rivargut/aire-nuevo/Box/BOX_F5.SLDPRT

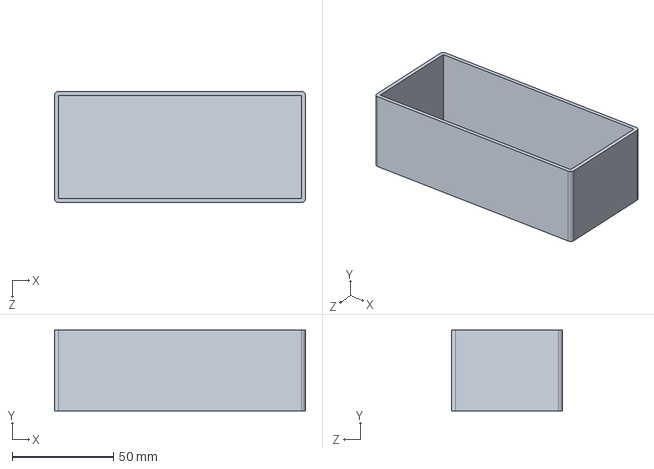
[picture p1: CAD file, 2020-01-30]
Box/BOX_F5.SLDPRT
124.0 x 40.0 x 55.0 mm
