rivargut/aire-nuevo/(list of files, cad)

Other CAD files:
Box/Box F5.SLDPRT
Box/Box F5.STL
