rivargut/aire-nuevo/ECUGPSrev2/ECU GPS Schematic.pdf

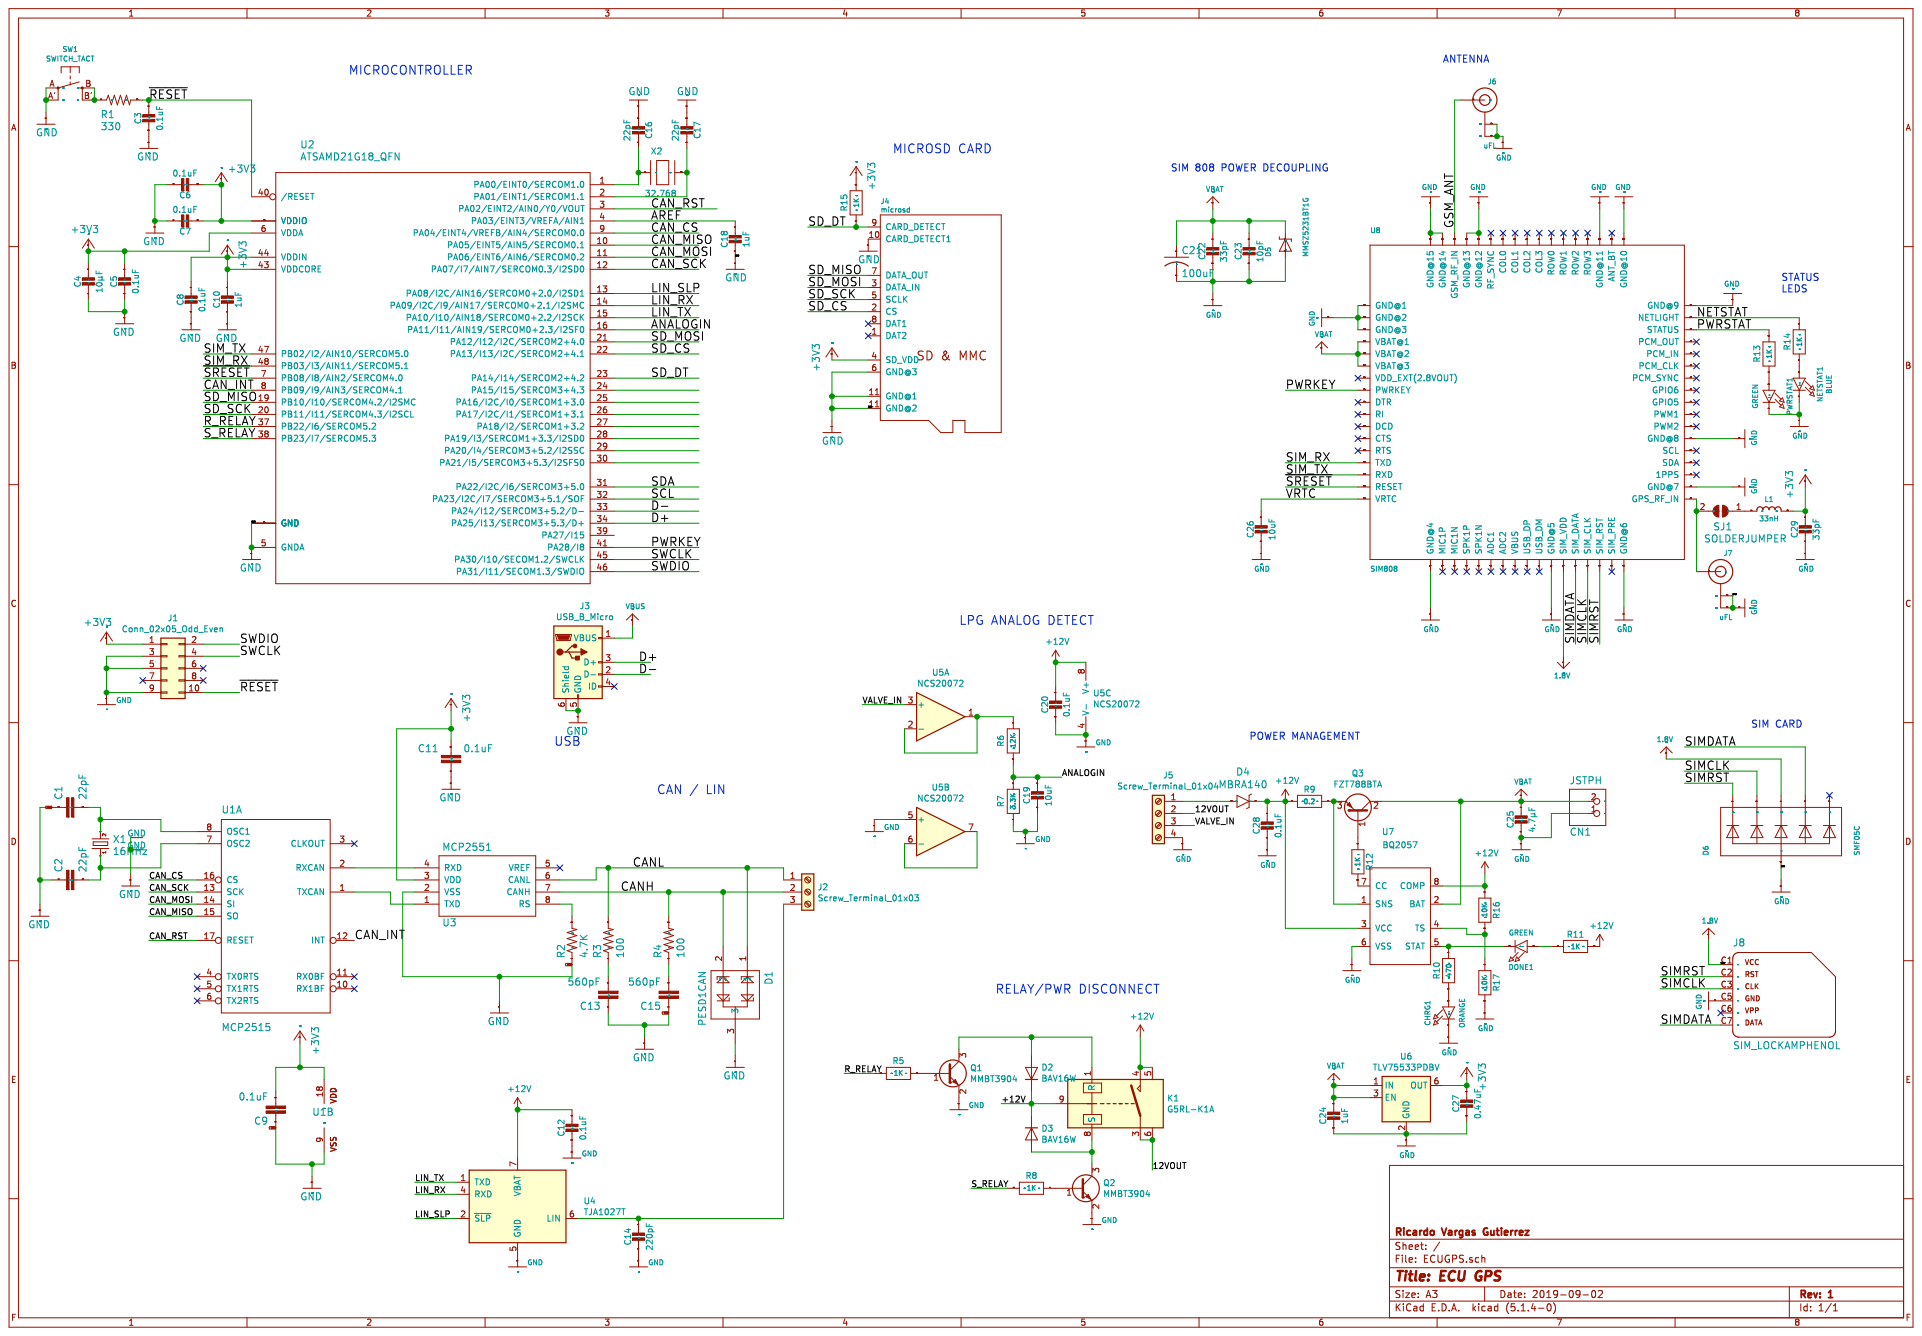
[picture p2: page 1]
