rivargut/aire-nuevo/ECUGPSrev2/ECUGPS.kicad_pcb

## KiCad design ECUGPSrev2/ECUGPS.kicad_pcb (2020-06-15)

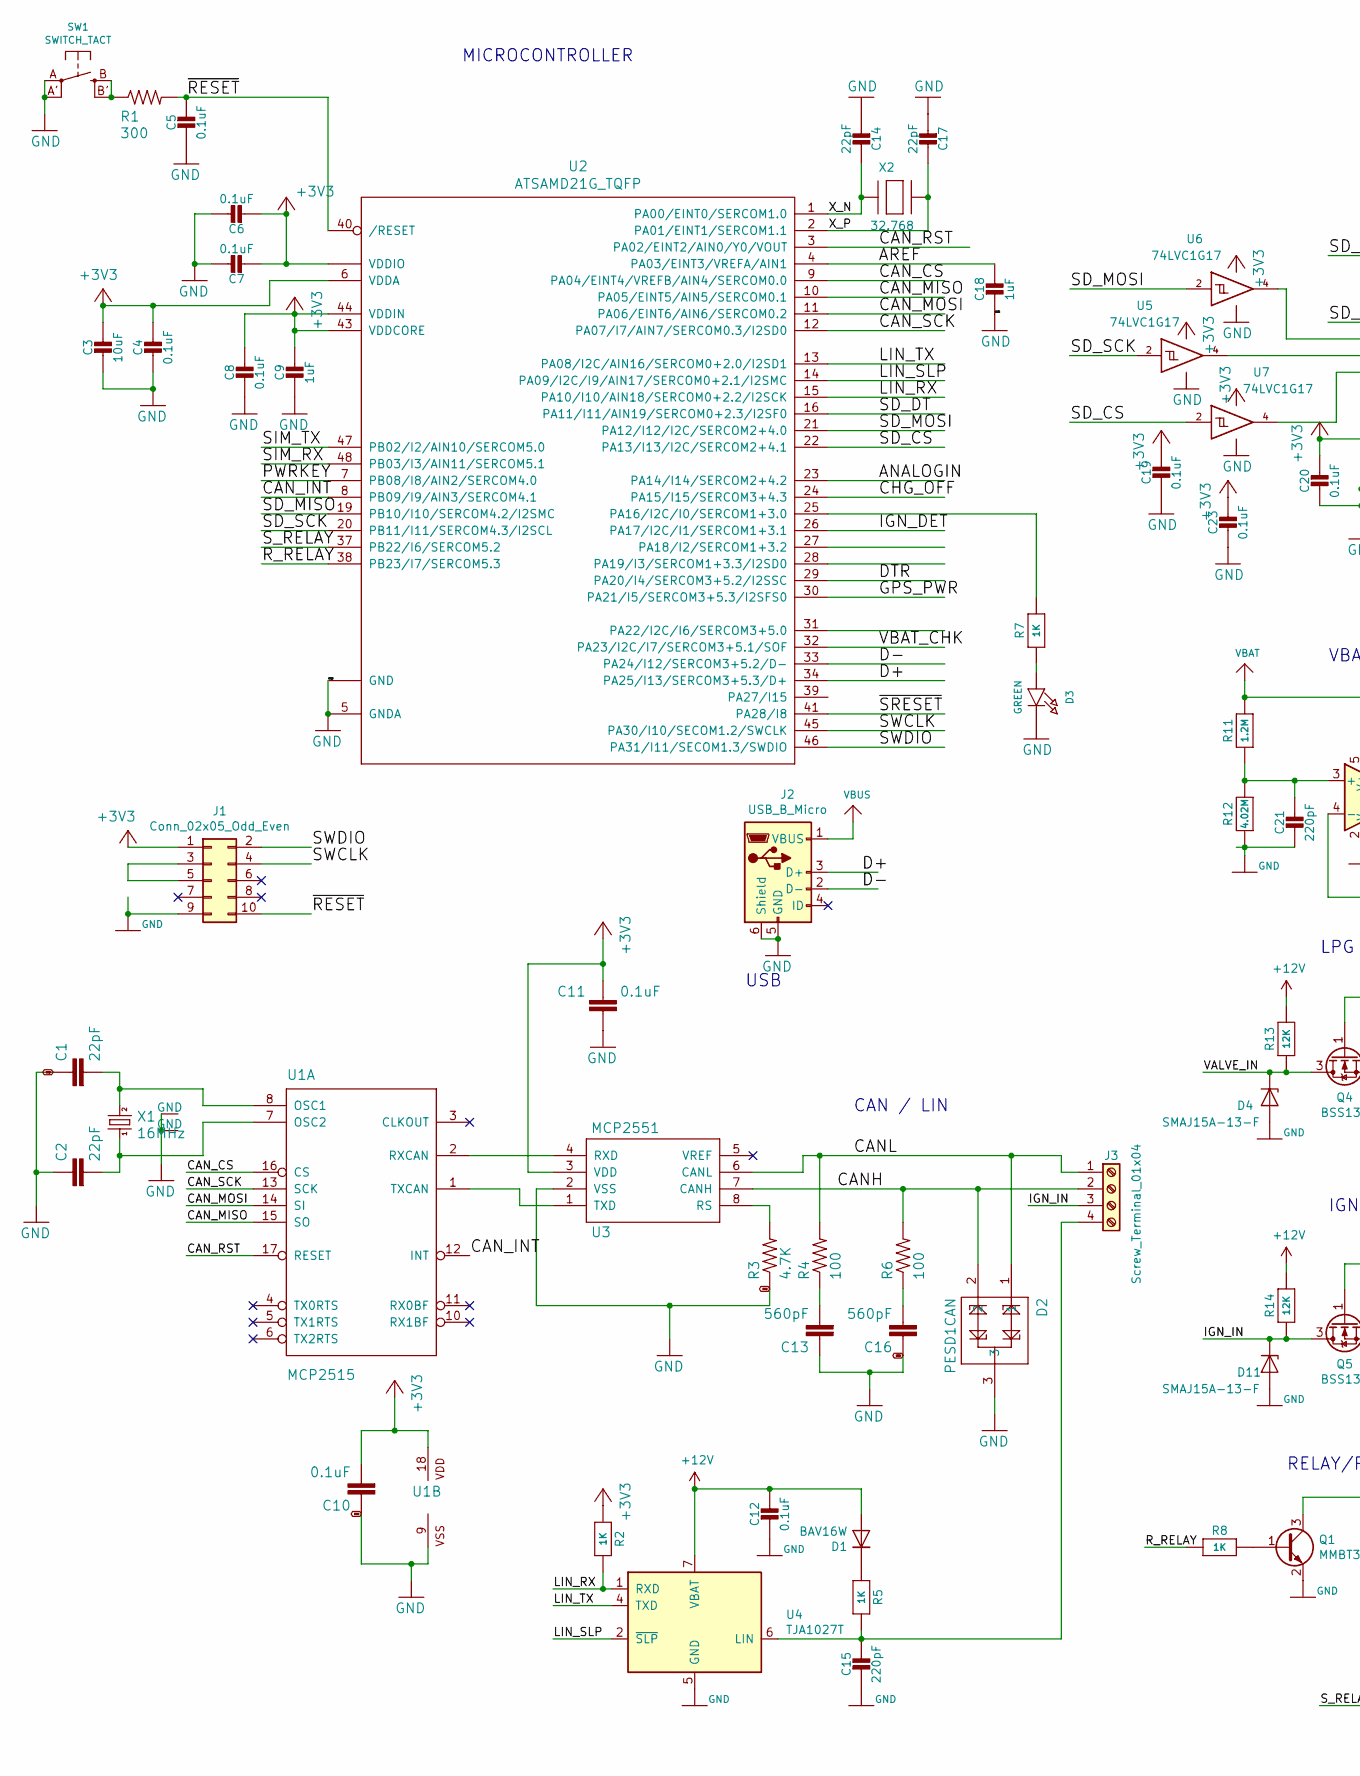
[picture p3: schematic ECUGPS.sch, ECU GPS, part in row 1, column 1]

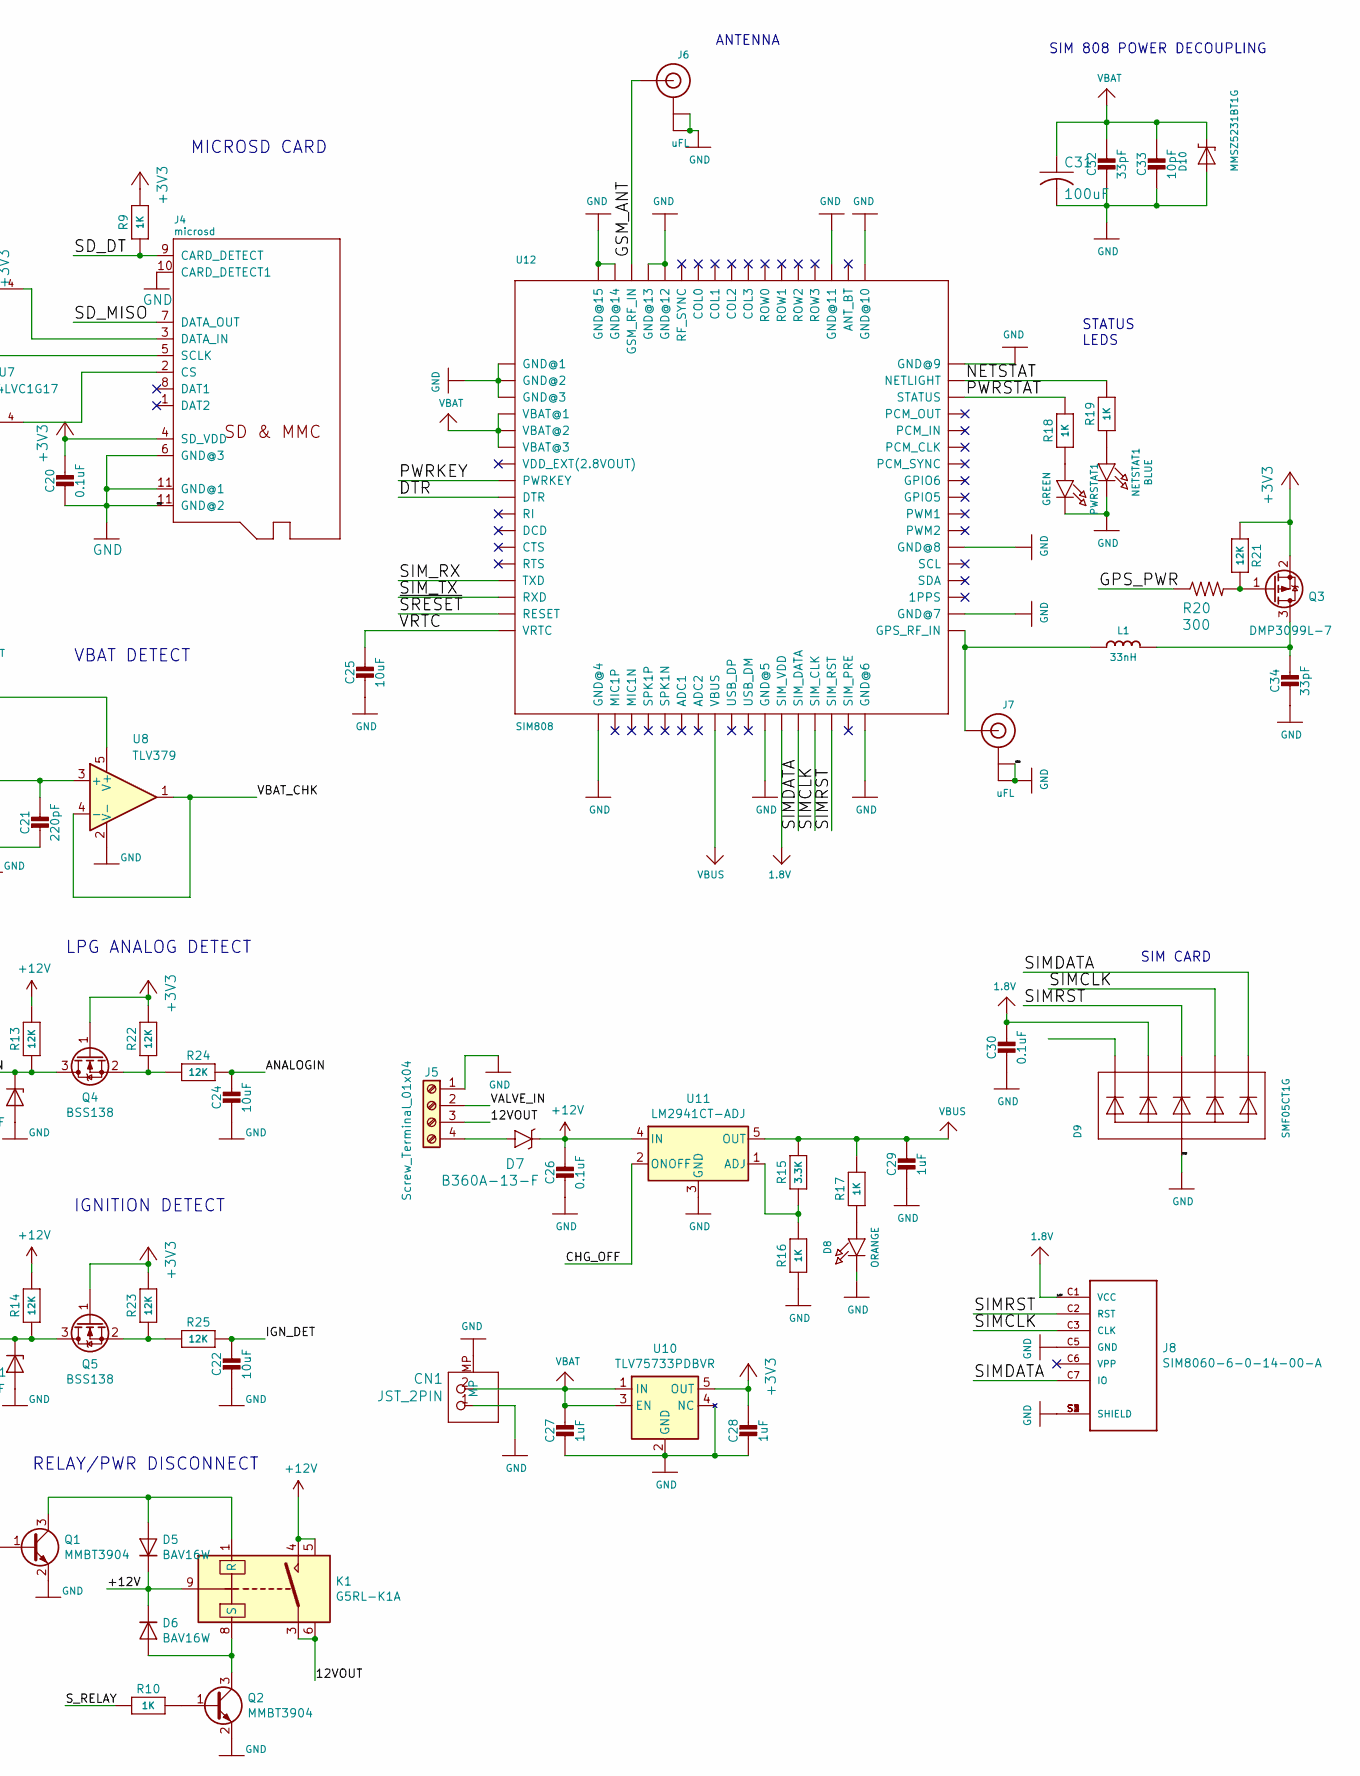
[picture p4: schematic ECUGPS.sch, ECU GPS, part in row 1, column 2]

Parts:
C1, C2, C14, C17: 22pF; C_0603_1608Metric; Part CC0603JRNPO9BN220
C3, C22, C24, C25: 10uF; C_0603_1608Metric; Part 0603ZD106KAT2A
C4, C5, C6, C7, C8, C10, C11, C12, C19, C20, C23, C26, C30: 0.1uF; C_0603_1608Metric; Part CL10B104KB8NNNL
C9, C18, C27, C28, C29: 1uF; C_0603_1608Metric; Part CL10A105KP8NNNC
C13, C16: 560pF; C_0603_1608Metric; Part CL10B561KB8NNNC
C15, C21: 220pF; C_0603_1608Metric; Part CL10B221KB8NNNC
C31: 100uF; C_1206_3216Metric; Part CL31A107MQHNNNE
C32, C34: 33pF; C_0603_1608Metric; Part CL10C330JB8NNNC
C33: 10pF; C_0603_1608Metric; Part CL10C100JB8NNNC
CN1: JST_2PIN; JST_PH_S2B-PH-SM4-TB_1x02-1MP_P2.00mm_Horizontal
D1, D5, D6: BAV16W; D_SOD-123; Part BAV16W-7-F
D2: PESD1CAN; SOT-23; Part PESD1CAN-UX
D3: GREEN; LED_0805_2012Metric; Part 150080VS75000
D4, D11: SMAJ15A-13-F; D_SMA
D7: B360A-13-F‎; D_SMA; Part B360A-13-F‎
D8: ORANGE; LED_0805_2012Metric; Part LTST-C170KFKT
D9: SMF05CT1G; SOT-363_SC-70-6; Part SMF05CT1G
D10: MMSZ5231BT1G; D_SOD-123; Part MSZ5231BT1G
J1: Conn_02x05_Odd_Even; PinHeader_2x5_P1.27mm; Part 20021121-00010C4LF
J2: USB_B_Micro; GCT_USB3145-XX-X_REVB; Part 1050170001
J3, J5: Screw_Terminal_01x04; TerminalBlock_Phoenix_MPT-0,5-4-2.54_1x04_P2.54mm_Horizontal; Part OSTVN04A150
J4: microsd; Hirose_DM3D-SF; Part M3D-SF(41)
J6, J7: uFL; U.FL_Molex_MCRF_73412-0110_Vertical; Part 0734120110
J8: SIM8060-6-0-14-00-A; GCT_SIM8060-6-0-14-00-A
K1: G5RL-K1A; Relay_SPST_Omron_G5RL; Part G5RL-K1A-E-DC12
L1: 33nH; L_0805; Part CE201210-33NJ
NETSTAT1: BLUE; LED_0805_2012Metric; Part 150080BS75000
PWRSTAT1: GREEN; LED_0805_2012Metric; Part 150080VS75000
Q1, Q2: MMBT3904; SOT-23; Part MMBT3904
Q3: DMP3099L-7; SOT-23
Q4, Q5: BSS138; SOT-23
R1, R20: 300; R_0805_2012Metric; Part ERJ-6GEYJ301V
R2, R5, R7, R8, R9, R10, R16, R17, R18, R19: 1K; R_0805_2012Metric; Part ERJ-6ENF1001V
R3: 4.7K; R_0805_2012Metric; Part ERJ-6ENF4701V
R4, R6: 100; R_0805_2012Metric; Part ERJ-6ENF1000V
R11: 1.2M; R_0805_2012Metric; Part ERJ-6ENF1204V
R12: 4.02M; R_0805_2012Metric; Part RC0805FR-074M02L
R13, R14, R21, R22, R23, R24, R25: 12K; R_0805_2012Metric; Part ERJ-6ENF1202V
R15: 3.3K; R_0805_2012Metric; Part ERJ-6ENF3301V
SW1: SWITCH_TACT; EVQ-Q2; Part EVQ-Q2B03W
U1: MCP2515; SOIC-18W_7.5x11.6mm_Pitch1.27mm; Part MCP2515T-I/SO
U2: ATSAMD21G_TQFP; TQFP-48_7x7mm_P0.5mm
U3: MCP2551; SOIC-8_3.9x4.9mm_P1.27mm; Part MCP2551T-I/SN
U4: TJA1027T; SOIC-8_3.9x4.9mm_P1.27mm; Part TJA1027T/20
U5, U6, U7: 74LVC1G17; SOT-23-5
U8: TLV379; TSOP-5_1.65x3.05mm_P0.95mm
U10: TLV75733PDBVR; SOT-23-5; Part TLV75733PDBVR
U11: LM2941CT-ADJ; TO-220-5_Vertical
U12: SIM808; SIM900_SMT; Part SIM808
X1: 16MHz; Crystal_SMD_Abracon_ABM3B-4Pin_5.0x3.2mm; Part ABM3B-16.000MHZ-B2-T
X2: 32.768; Crystal_SMD_G8-2pin_3.2x1.5mm; Part FC-135 32.7680KA-A5

Connections:
1.8V: C30.1, D9.3 (C2), J8.C1 (VCC), U12.P$29 (SIM_VDD)
+3V3: C3.1, C4.1, C6.2, C7.2, C8.1, C9.1, C10.2, C11.2, C19.1, C20.1, C23.1, C28.1, J1.1, J4.4 (SD_VDD), Q3.2 (S), Q4.1 (G), Q5.1 (G), R2.2, R9.2, R21.2, R22.1, R23.1, U1.18 (VDD), U2.6 (VDDA), U2.17 (VDDIO), U2.36 (VDDIO), U2.43 (VDDCORE), U2.44 (VDDIN), U3.3 (VDD), U5.5 (VCC), U6.5 (VCC), U7.5 (VCC), U10.5 (OUT)
+12V: C12.1, C26.1, D1.2 (A), D5.1 (K), D6.1 (K), D7.1, K1.4, K1.5, K1.9, R13.1, R14.1, U4.7 (VBAT), U11.4 (IN)
/12VOUT: J5.3, K1.3, K1.6
/ANALOGIN: C24.1, R24.1, U2.23 (PA14/I14/SERCOM2+4.2)
/AREF: C18.1, U2.4 (PA03/EINT3/VREFA/AIN1)
/CANH: D2.2, J3.2, R6.2, U3.7 (CANH)
/CANL: D2.1, J3.1, R4.2, U3.6 (CANL)
/CAN_CS: U1.16 (CS), U2.9 (PA04/EINT4/VREFB/AIN4/SERCOM0.0)
/CAN_INT: U1.12 (INT), U2.8 (PB09/I9/AIN3/SERCOM4.1)
/CAN_MISO: U1.15 (SO), U2.10 (PA05/EINT5/AIN5/SERCOM0.1)
/CAN_MOSI: U1.14 (SI), U2.11 (PA06/EINT6/AIN6/SERCOM0.2)
/CAN_RST: U1.17 (RESET), U2.3 (PA02/EINT2/AIN0/Y0/VOUT)
/CAN_SCK: U1.13 (SCK), U2.12 (PA07/I7/AIN7/SERCOM0.3/I2SD0)
/CHG_OFF: U2.24 (PA15/I15/SERCOM3+4.3), U11.2 (ONOFF)
/D+: J2.3 (D+), U2.34 (PA25/I13/SERCOM3+5.3/D+)
/D-: J2.2 (D-), U2.33 (PA24/I12/SERCOM3+5.2/D-)
/DTR: U2.29 (PA20/I4/SERCOM3+5.2/I2SSC), U12.P$9 (DTR)
/GPS_PWR: R20.1, U2.30 (PA21/I5/SERCOM3+5.3/I2SFS0)
/GSM_ANT: J6.1 (SIGNAL), U12.P$66 (GSM_RF_IN)
/IGN_DET: C22.1, R25.1, U2.26 (PA17/I2C/I1/SERCOM1+3.1)
/IGN_IN: D11.1 (K), J3.3, Q5.3 (D), R14.2
/LIN_RX: R2.1, U2.15 (PA10/I10/AIN18/SERCOM0+2.2/I2SCK), U4.1 (RXD)
/LIN_SLP: U2.14 (PA09/I2C/I9/AIN17/SERCOM0+2.1/I2SMC), U4.2 (~SLP~)
/LIN_TX: U2.13 (PA08/I2C/AIN16/SERCOM0+2.0/I2SD1), U4.4 (TXD)
/NETSTAT: R19.2, U12.P$50 (NETLIGHT)
/PWRKEY: U2.7 (PB08/I8/AIN2/SERCOM4.0), U12.P$8 (PWRKEY)
/PWRSTAT: R18.2, U12.P$49 (STATUS)
/R_RELAY: R8.2, U2.38 (PB23/I7/SERCOM5.3)
/SD_CS: U2.22 (PA13/I13/I2C/SERCOM2+4.1), U7.2
/SD_DT: J4.9 (CARD_DETECT), R9.1, U2.16 (PA11/I11/AIN19/SERCOM0+2.3/I2SF0)
/SD_MISO: J4.7 (DATA_OUT), U2.19 (PB10/I10/SERCOM4.2/I2SMC)
/SD_MOSI: U2.21 (PA12/I12/I2C/SERCOM2+4.0), U6.2
/SD_SCK: U2.20 (PB11/I11/SERCOM4.3/I2SCL), U5.2
/SIMCLK: D9.5 (C4), J8.C3 (CLK), U12.P$31 (SIM_CLK)
/SIMDATA: D9.6 (C5), J8.C7 (IO), U12.P$30 (SIM_DATA)
/SIMRST: D9.4 (C3), J8.C2 (RST), U12.P$32 (SIM_RST)
/SIM_RX: U2.48 (PB03/I3/AIN11/SERCOM5.1), U12.P$14 (TXD)
/SIM_TX: U2.47 (PB02/I2/AIN10/SERCOM5.0), U12.P$15 (RXD)
/SWCLK: J1.4, U2.45 (PA30/I10/SECOM1.2/SWCLK)
/SWDIO: J1.2, U2.46 (PA31/I11/SECOM1.3/SWDIO)
/S_RELAY: R10.2, U2.37 (PB22/I6/SERCOM5.2)
/VALVE_IN: D4.1 (K), J5.2, Q4.3 (D), R13.2
/VBAT_CHK: U2.32 (PA23/I2C/I7/SERCOM3+5.1/SOF), U8.1, U8.4 (-)
/VRTC: C25.1, U12.P$17 (VRTC)
/X_N: C14.1, U2.1 (PA00/EINT0/SERCOM1.0), X2.1
/X_P: C17.1, U2.2 (PA01/EINT1/SERCOM1.1), X2.2
/~RESET: C5.1, J1.10, R1.2, U2.40 (/RESET)
/~SRESET: U2.41 (PA28/I8), U12.P$16 (RESET)
GND: C1.1, C2.1, C3.2, C4.2, C5.2, C6.1, C7.1, C8.2, C9.2, C10.1, C11.1, C12.2, C13.1, C14.2, C15.2, C16.1, C17.2, C18.2, C19.2, C20.2, C21.2, C22.2, C23.2, C24.2, C25.2, C26.2, C27.2, C28.2, C29.2, C30.2, C31.2, C32.2, C33.2, C34.2, CN1.1, CN1.MP, D2.3, D3.1 (C), D4.2 (A), D8.1 (C), D9.2 (A), D10.2, D11.2 (A), J1.9, J2.5 (GND), J2.6 (Shield), J4.6 (GND@3), J4.10 (CARD_DETECT1), J4.11 (GND@1), J5.1, J6.2 (GND@0), J7.2 (GND@0), J8.C5 (GND), J8.S1 (SHIELD), J8.S2 (SHIELD), J8.S3 (SHIELD), J8.S4 (SHIELD), NETSTAT1.1 (C), PWRSTAT1.1 (C), Q1.2 (E), Q2.2 (E), R3.1, R12.2, R16.1, SW1.A, SW1.A' (P1), U1.9 (VSS), U2.5 (GNDA), U2.18 (GND), U2.35 (GND), U2.42 (GND), U3.2 (VSS), U4.5 (GND), U5.3 (GND), U6.3 (GND), U7.3 (GND), U8.2 (V-), U10.2 (GND), U10.4 (NC), U11.3 (GND), U12.P$1 (GND@1), U12.P$2 (GND@2), U12.P$3 (GND@3), U12.P$18 (GND@4), U12.P$28 (GND@5), U12.P$34 (GND@6), U12.P$36 (GND@7), U12.P$40 (GND@8), U12.P$51 (GND@9), U12.P$52 (GND@10), U12.P$54 (GND@11), U12.P$64 (GND@12), U12.P$65 (GND@13), U12.P$67 (GND@14), U12.P$68 (GND@15), X1.2 (GND), X1.4 (GND)
unnamed: C1.2, U1.8 (OSC1), X1.3 (2)
unnamed: C2.2, U1.7 (OSC2), X1.1
unnamed: C13.2, R4.1
unnamed: C15.1, J3.4, R5.1, U4.6 (LIN)
unnamed: C16.2, R6.1
unnamed: C21.1, R11.2, R12.1, U8.3 (+)
unnamed: C34.1, L1.2, Q3.3 (D)
unnamed: D1.1 (K), R5.2
unnamed: D3.2 (A), R7.1
unnamed: D5.2 (A), K1.1 (R), Q1.3 (C)
unnamed: D6.2 (A), K1.8 (S), Q2.3 (C)
unnamed: D7.2, J5.4
unnamed: D8.2 (A), R17.1
unnamed: J1.3, J1.5
unnamed: J4.2 (CS), U7.4
unnamed: J4.3 (DATA_IN), U6.4
unnamed: J4.5 (SCLK), U5.4
unnamed: J7.1 (SIGNAL), L1.1, U12.P$35 (GPS_RF_IN)
unnamed: NETSTAT1.2 (A), R19.1
unnamed: PWRSTAT1.2 (A), R18.1
unnamed: Q1.1 (B), R8.1
unnamed: Q2.1 (B), R10.1
unnamed: Q3.1 (G), R20.2, R21.1
unnamed: Q4.2 (S), R22.2, R24.2
unnamed: Q5.2 (S), R23.2, R25.2
unnamed: R1.1, SW1.B (S), SW1.B' (S1)
unnamed: R3.2, U3.8 (RS)
unnamed: R7.2, U2.25 (PA16/I2C/I0/SERCOM1+3.0)
unnamed: R15.2, R16.2, U11.1 (ADJ)
unnamed: U1.1 (TXCAN), U3.1 (TXD)
unnamed: U1.2 (RXCAN), U3.4 (RXD)
VBAT: C27.1, C31.1, C32.1, C33.1, CN1.2, D10.1, R11.1, U8.5 (V+), U10.1 (IN), U10.3 (EN), U12.P$4 (VBAT@1), U12.P$5 (VBAT@2), U12.P$6 (VBAT@3)
VBUS: C29.1, J2.1 (VBUS), R15.1, R17.2, U11.5 (OUT), U12.P$25 (VBUS)

Notes on the sheet:
ANTENNA
SIM 808 POWER DECOUPLING
SIM CARD
STATUS LEDS
MICROCONTROLLER
MICROSD CARD
USB
CAN / LIN
LPG ANALOG DETECT
RELAY/PWR DISCONNECT
VBAT DETECT
IGNITION DETECT

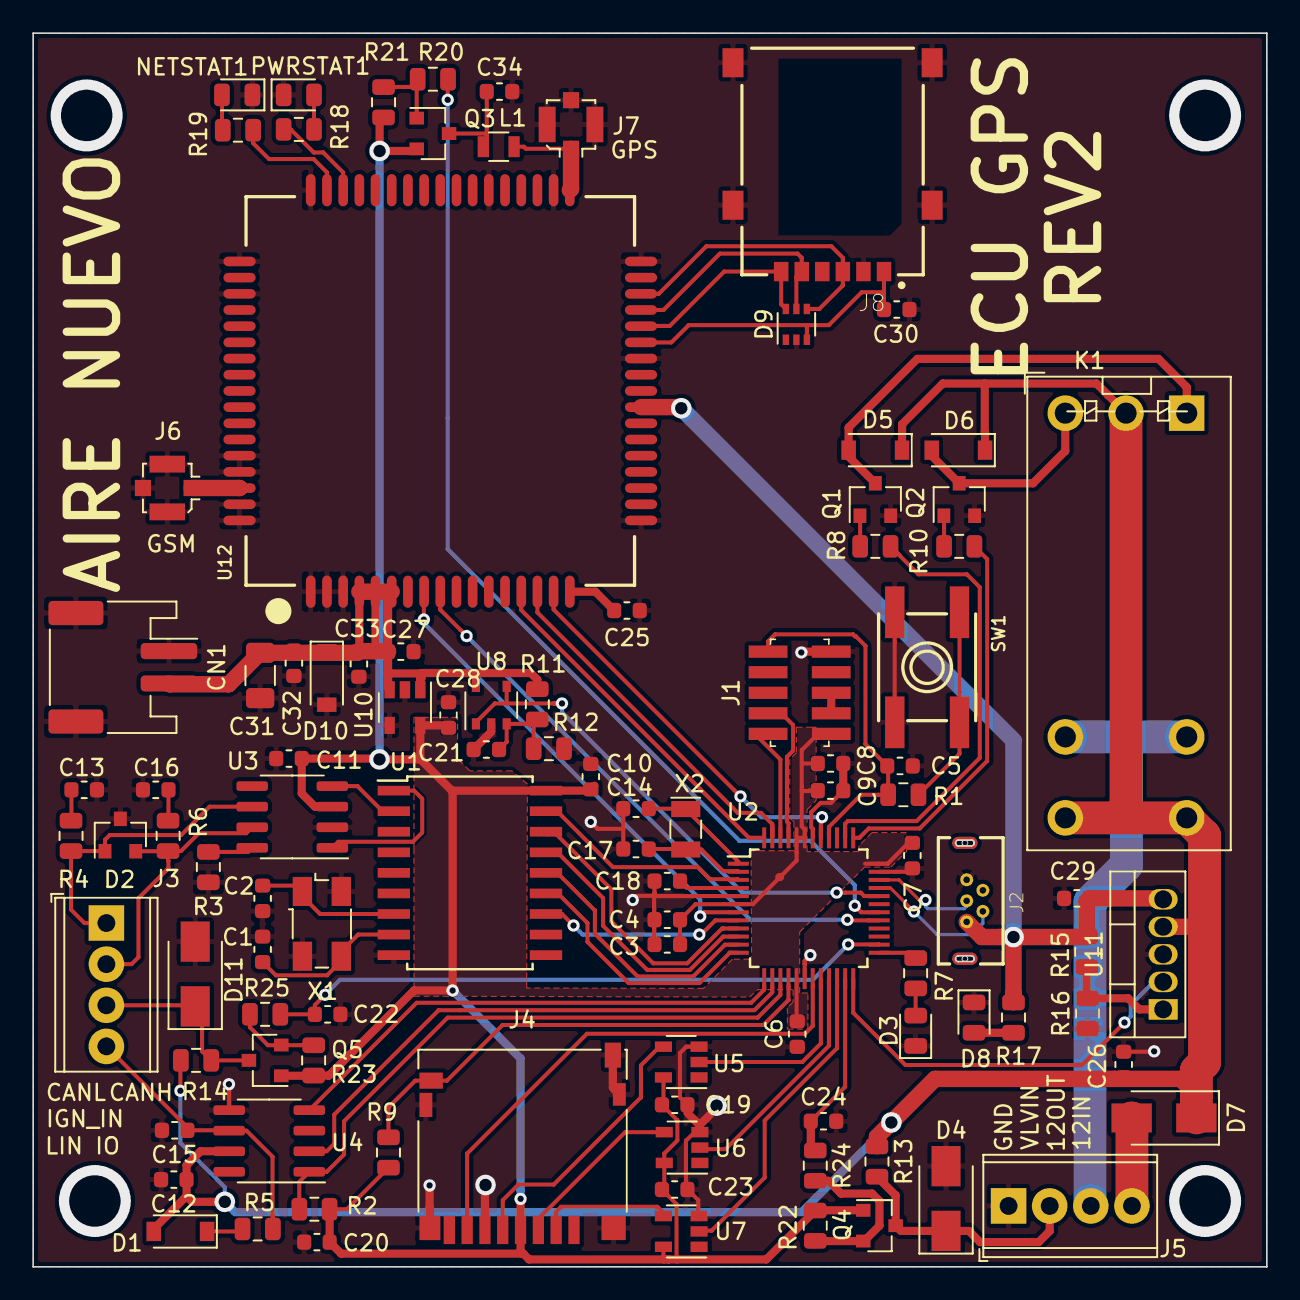
[picture p5: board ECUGPS.kicad_pcb from above]

Board: 2 copper layers, 76.2 x 76.2 mm, 102 parts (0 on the bottom side), 83 nets.
