rivargut/aire-nuevo/ECUGPS_sleep_r2/ecugps_r2/variant.h

/*
  Copyright (c) 2014-2015 Arduino LLC.  All right reserved.

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
  You should have received a copy of the GNU Lesser General Public
  License along with this library; if not, write to the Free Software
  Foundation, Inc., 51 Franklin St, Fifth Floor, Boston, MA  02110-1301  USA
*/

#ifndef _VARIANT_ARDUINO_ZERO_
#define _VARIANT_ARDUINO_ZERO_

// The definitions here needs a SAMD core >=1.6.10
#define ARDUINO_SAMD_VARIANT_COMPLIANCE 10610

/*----------------------------------------------------------------------------
 *        Definitions
 *----------------------------------------------------------------------------*/

/** Frequency of the board main oscillator */
#define VARIANT_MAINOSC		(32768ul)

/** Master clock frequency */
#define VARIANT_MCK			  (48000000ul)

/*----------------------------------------------------------------------------
 *        Headers
 *----------------------------------------------------------------------------*/

#include "WVariant.h"

#ifdef __cplusplus
#include "SERCOM.h"
#include "Uart.h"
#endif // __cplusplus

#ifdef __cplusplus
extern "C"
{
#endif // __cplusplus

/*----------------------------------------------------------------------------
 *        Pins
 *----------------------------------------------------------------------------*/

// Number of pins defined in PinDescription array
#ifdef __cplusplus
extern "C" unsigned int PINCOUNT_fn();
#endif
#define PINS_COUNT           (PINCOUNT_fn())
#define NUM_DIGITAL_PINS     (20u)
#define NUM_ANALOG_INPUTS    (1u)
#define NUM_ANALOG_OUTPUTS   (1u)
#define analogInputToDigitalPin(p)  ((p < 6u) ? (p) + 14u : -1)

#define digitalPinToPort(P)        ( &(PORT->Group[g_APinDescription[P].ulPort]) )
#define digitalPinToBitMask(P)     ( 1 << g_APinDescription[P].ulPin )
//#define analogInPinToBit(P)        ( )
#define portOutputRegister(port)   ( &(port->OUT.reg) )
#define portInputRegister(port)    ( &(port->IN.reg) )
#define portModeRegister(port)     ( &(port->DIR.reg) )
#define digitalPinHasPWM(P)        ( g_APinDescription[P].ulPWMChannel != NOT_ON_PWM || g_APinDescription[P].ulTCChannel != NOT_ON_TIMER )

/*
 * digitalPinToTimer(..) is AVR-specific and is not defined for SAMD
 * architecture. If you need to check if a pin supports PWM you must
 * use digitalPinHasPWM(..).
 *
 * https://github.com/arduino/Arduino/issues/1833
 */
// #define digitalPinToTimer(P)

// LEDs

/*
 * Analog pins
 */
#define PIN_A0               (0ul)


static const uint8_t A0  = PIN_A0;
#define ADC_RESOLUTION		12


/*
 * Serial interfaces
 */

#define Serial SerialUSB

// Serial1
#define PIN_SERIAL1_RX       (6ul)
#define PIN_SERIAL1_TX       (5ul)
#define PAD_SERIAL1_TX       (UART_TX_PAD_0)
#define PAD_SERIAL1_RX       (SERCOM_RX_PAD_1)

// Serial2
#define PIN_SERIAL2_RX       (2ul)
#define PIN_SERIAL2_TX       (1ul)
#define PAD_SERIAL2_TX       (UART_TX_PAD_0)
#define PAD_SERIAL2_RX       (SERCOM_RX_PAD_2)

/*
 * SPI Interfaces
 */
#define SPI_INTERFACES_COUNT 2
// SPI 0 (default) for SD card
#define PIN_SPI_MOSI         (10u)
#define PIN_SPI_MISO         (11u)
#define PIN_SPI_SCK          (12u)
#define PIN_SS				 (13u)
#define PERIPH_SPI           sercom4
#define PAD_SPI_TX           SPI_PAD_0_SCK_3
#define PAD_SPI_RX           SERCOM_RX_PAD_0

static const uint8_t SS   = PIN_SS;
static const uint8_t MOSI = PIN_SPI_MOSI ;
static const uint8_t MISO = PIN_SPI_MISO ;
static const uint8_t SCK  = PIN_SPI_SCK ;

// SPI 1 (default) for CAN controller
#define PIN_SPI1_MISO         (21u)
#define PIN_SPI1_MOSI         (22u)
#define PIN_SPI1_SCK          (23u)
#define PIN_SS1				  (24u)
#define PERIPH_SPI1           sercom0
#define PAD_SPI1_TX           SPI_PAD_2_SCK_3
#define PAD_SPI1_RX           SERCOM_RX_PAD_1

static const uint8_t SS1   = PIN_SS1;
static const uint8_t MOSI1 = PIN_SPI1_MOSI ;
static const uint8_t MISO1 = PIN_SPI1_MISO ;
static const uint8_t SCK1  = PIN_SPI1_SCK ;


/*
 * Wire Interfaces
 */
#define WIRE_INTERFACES_COUNT 1

#define PIN_WIRE_SDA         (17u)
#define PIN_WIRE_SCL         (18u)
#define PERIPH_WIRE          sercom3
#define WIRE_IT_HANDLER      SERCOM3_Handler

static const uint8_t SDA = PIN_WIRE_SDA;
static const uint8_t SCL = PIN_WIRE_SCL;

/*
 * USB
 */

#define PIN_USB_DM          (15ul)
#define PIN_USB_DP          (16ul)

/*
 * I2S Interfaces
 */
#define I2S_INTERFACES_COUNT 1

#define I2S_DEVICE          0
#define I2S_CLOCK_GENERATOR 3
#define PIN_I2S_SD          (9u)
#define PIN_I2S_SCK         (1u)
#define PIN_I2S_FS          (0u)

#ifdef __cplusplus
}
#endif

/*----------------------------------------------------------------------------
 *        Arduino objects - C++ only
 *----------------------------------------------------------------------------*/

#ifdef __cplusplus

/*	=========================
 *	===== SERCOM DEFINITION
 *	=========================
*/
extern SERCOM sercom0;
//extern SERCOM sercom1;
extern SERCOM sercom2;
//extern SERCOM sercom3;
extern SERCOM sercom4;
extern SERCOM sercom5;

extern Uart Serial1;
extern Uart Serial2;

#endif

#ifdef __cplusplus
extern "C" {
#endif
unsigned int PINCOUNT_fn();
#ifdef __cplusplus
}
#endif

// These serial port names are intended to allow libraries and architecture-neutral
// sketches to automatically default to the correct port name for a particular type
// of use.  For example, a GPS module would normally connect to SERIAL_PORT_HARDWARE_OPEN,
// the first hardware serial port whose RX/TX pins are not dedicated to another use.
//
// SERIAL_PORT_MONITOR        Port which normally prints to the Arduino Serial Monitor
//
// SERIAL_PORT_USBVIRTUAL     Port which is USB virtual serial
//
// SERIAL_PORT_LINUXBRIDGE    Port which connects to a Linux system via Bridge library
//
// SERIAL_PORT_HARDWARE       Hardware serial port, physical RX & TX pins.
//
// SERIAL_PORT_HARDWARE_OPEN  Hardware serial ports which are open for use.  Their RX & TX
//                            pins are NOT connected to anything by default.
#define SERIAL_PORT_USBVIRTUAL      SerialUSB
#define SERIAL_PORT_MONITOR         Serial
// Serial has no physical pins broken out, so it's not listed as HARDWARE port
#define SERIAL_PORT_HARDWARE        Serial1
#define SERIAL_PORT_HARDWARE_OPEN   Serial1

#endif /* _VARIANT_ARDUINO_ZERO_ */
