rivargut/aire-nuevo/(commit log)

2019-12-30 Add files via upload
    - Fixed reset on the SIM808 (pull up at start up)
    - Fixed port numbers
    [ECUGPS_r3.ino]
2019-12-30 Add files via upload
    Fixed pin definition
    [variant.cpp, variant.h]
2020-02-12 Add files via upload
    Changes up to 12 FEB,
    included battery voltage read command through SMS
    Other changes by Daniel
2020-02-24 Add files via upload
    FONA charge mode changes
2020-02-24 Add files via upload
    changes fro charger implementation
2020-02-26 Add files via upload
    Se habilita el modo de recarga de batería. Grabándolo en EPROM y reseteando del FONA automáticamente.
    [ECUGPS_test.ino]
2020-02-26 Add files via upload
    Se arregla el error al imprimir el porcentaje de batería antes de hacer httpost
    [ECUGPS_test.ino]
2020-02-28 Add files via upload
    Sleep test using RTC , with changes to usb detach and attach
2020-03-01 Add files via upload
    Se agrega una función que realiza un último post del día (23:58:00)
2020-03-01 Add files via upload
    Al final de la función httppost, se intenta apagar el gprs aunque parezca que no se logró encender. Esto porque a veces queda encendido
2020-03-01 Add files via upload
    Ediciones a la función DayClosingPost(). Además la función HTTPPost() ahora es de tipo bool y retorna la variable success
2020-03-02 Add files via upload
    El relay deja de ser alimentado. Esto para ahorro de energía. Sólo se alimenta en la transición de estado, y luego se vuelve a desconectar.
